lucadentella/PdL/OccupancyLNDecoder/v1/Eagle/LNOccupancy.brd

## EAGLE design OccupancyLNDecoder/v1/Eagle/LNOccupancy.brd (2016-12-05, an earlier design)

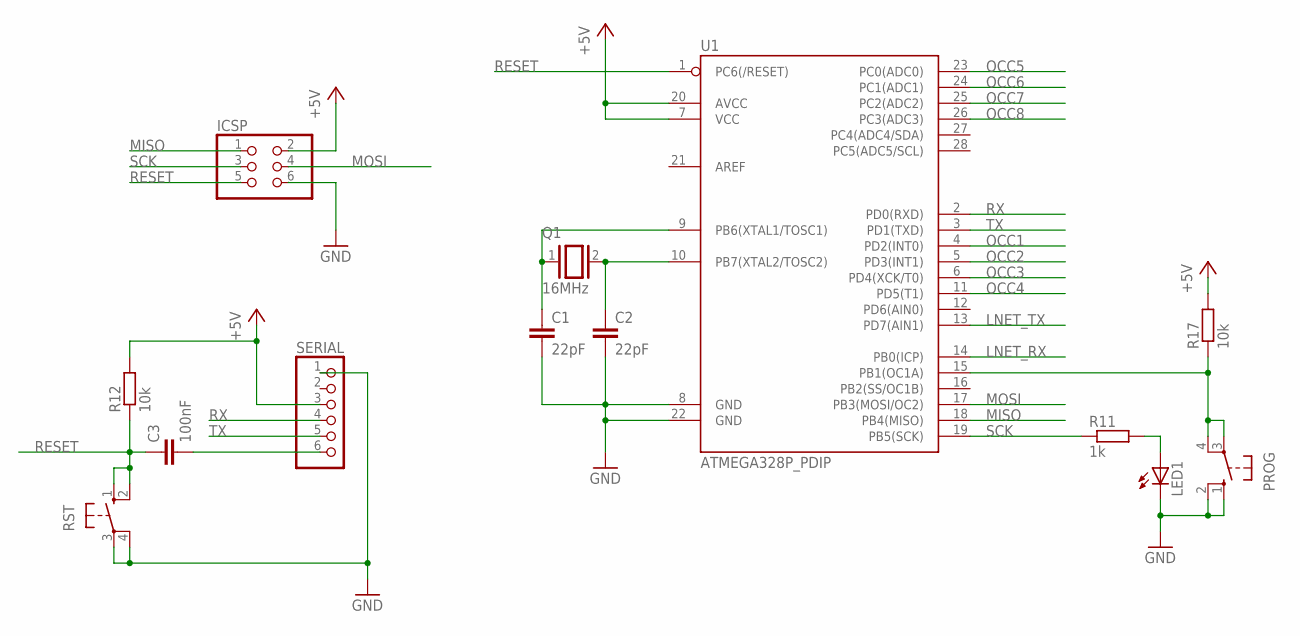
[picture p1: schematic LNOccupancy.sch, sheet 1]

Parts:
C1, C2: 22pF; C025-025X050
C3: 100nF; C050-025X075
ICSP: PINHD-2X3; 2X03
LED1: LED3MM
PROG: 10-XX; B3F-10XX
Q1: 16MHz; QS
R11: 1k; 0207/2V
R12, R17: 10k; 0207/2V
RST: 10-XX; B3F-10XX
SERIAL: PINHD-1X6; 1X06
U1: ATMEGA328P_PDIP; DIL28-3

Connections:
+5V: ICSP.2, R12.2, R17.2, SERIAL.3, U1.7 (VCC), U1.20 (AVCC); also elsewhere on the board
GND: C1.2, C2.2, ICSP.6, LED1.K (C), PROG.1 (S), PROG.2 (S1), RST.3, RST.4 (P1), SERIAL.1, U1.8 (GND), U1.22 (GND); also elsewhere on the board
LNET_RX: U1.14 (PB0(ICP)); also elsewhere on the board
LNET_TX: U1.13 (PD7(AIN1)); also elsewhere on the board
MISO: ICSP.1, U1.18 (PB4(MISO))
MOSI: ICSP.4, U1.17 (PB3(MOSI/OC2))
unnamed: C1.1, Q1.1, U1.9 (PB6(XTAL1/TOSC1))
unnamed: C2.1, Q1.2, U1.10 (PB7(XTAL2/TOSC2))
unnamed: LED1.A, R11.2
unnamed: C3.2, SERIAL.6
unnamed: PROG.3, PROG.4 (P1), R17.1, U1.15 (PB1(OC1A))
OCC1: U1.4 (PD2(INT0)); also elsewhere on the board
OCC2: U1.5 (PD3(INT1)); also elsewhere on the board
OCC3: U1.6 (PD4(XCK/T0)); also elsewhere on the board
OCC4: U1.11 (PD5(T1)); also elsewhere on the board
OCC5: U1.23 (PC0(ADC0)); also elsewhere on the board
OCC6: U1.24 (PC1(ADC1)); also elsewhere on the board
OCC7: U1.25 (PC2(ADC2)); also elsewhere on the board
OCC8: U1.26 (PC3(ADC3)); also elsewhere on the board
RESET: C3.1, ICSP.5, R12.1, RST.1 (S), RST.2 (S1), U1.1 (PC6(/RESET))
RX: SERIAL.4, U1.2 (PD0(RXD))
SCK: ICSP.3, R11.1, U1.19 (PB5(SCK))
TX: SERIAL.5, U1.3 (PD1(TXD))

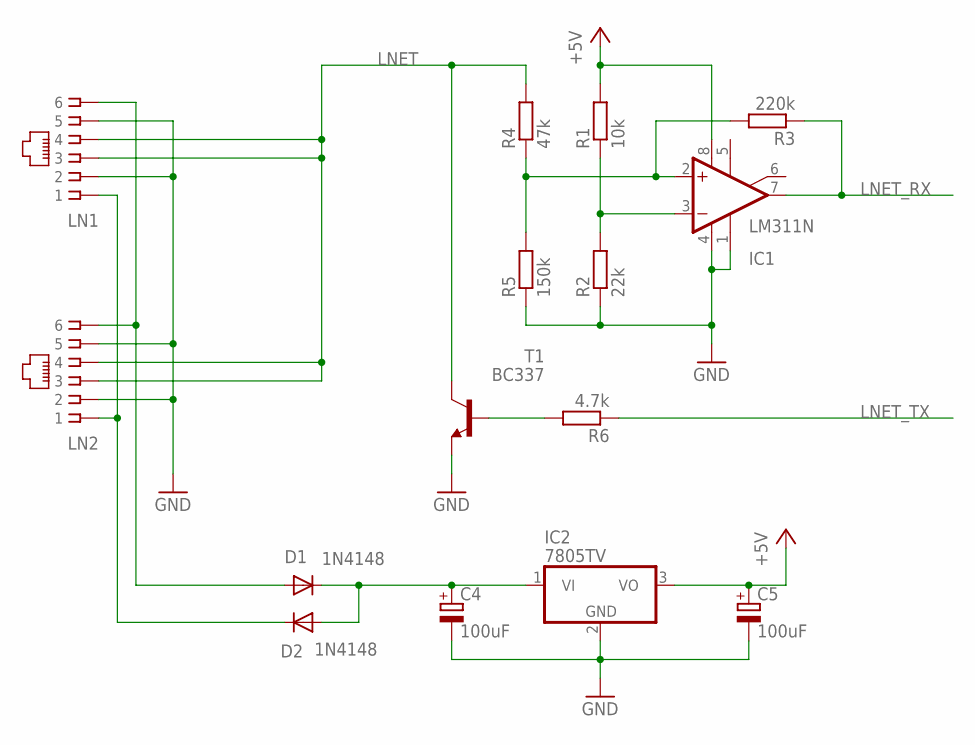
[picture p2: schematic LNOccupancy.sch, sheet 2]

Parts:
C4, C5: 100uF; E2,5-6
D1, D2: 1N4148; DO35-10
IC1: LM311N; DIL08
IC2: 7805TV; TO220V
LN1, LN2: RJ11-6X; RJ11-NO_SHIELD
R1: 10k; 0207/2V
R2: 22k; 0207/2V
R3: 220k; 0207/2V
R4: 47k; 0207/2V
R5: 150k; 0207/2V
R6: 4.7k; 0207/2V
T1: BC337; TO92

Connections:
+5V: C5.+, IC1.8 (V+), IC2.3 (VO), R1.2; also elsewhere on the board
GND: C4.-, C5.-, IC1.1 (GND), IC1.4 (V-), IC2.2 (GND), LN1.2, LN1.5, LN2.2, LN2.5, R2.1, R5.1, T1.1 (E); also elsewhere on the board
LNET: LN1.3, LN1.4, LN2.3, LN2.4, R4.2, T1.3 (C)
LNET_RX: IC1.7 (OUT), R3.1; also elsewhere on the board
LNET_TX: R6.1; also elsewhere on the board
unnamed: R6.2, T1.2 (B)
unnamed: IC1.3 (-IN), R1.1, R2.2
unnamed: IC1.2 (+IN), R3.2, R4.1, R5.2
unnamed: C4.+, D1.C, D2.A, IC2.1 (VI)
RAILSYNC_A: D1.A, LN1.6, LN2.6
RAILSYNC_B: D2.C, LN1.1, LN2.1

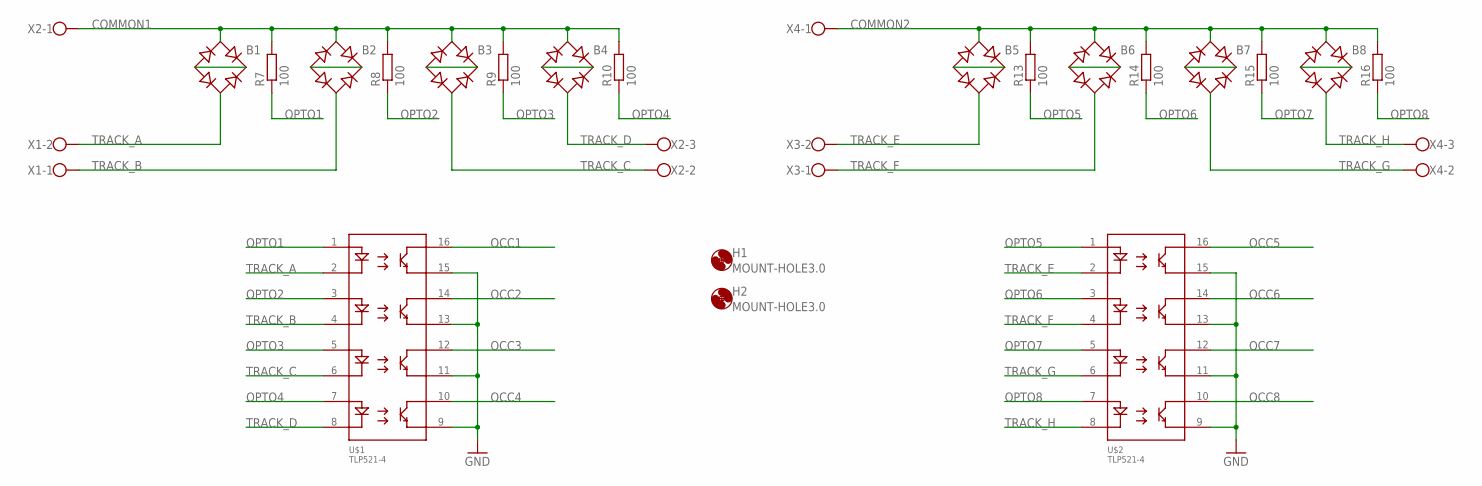
[picture p3: schematic LNOccupancy.sch, sheet 3]

Parts:
B1, B2, B3, B4, B5, B6, B7, B8: RB1A
H1, H2: MOUNT-HOLE3.0; 3,0
R7, R8, R9, R10, R13, R14, R15, R16: 100; 0207/2V
U$1, U$2: TLP521-4; DIL16
X1, X3: W237-102
X2, X4: W237-103

Connections:
COMMON1: B1.AC1, B2.AC1, B3.AC1, B4.AC1, R7.2, R8.2, R9.2, R10.2, X2.1
COMMON2: B5.AC1, B6.AC1, B7.AC1, B8.AC1, R13.2, R14.2, R15.2, R16.2, X4.1
GND: U$1.9, U$1.11, U$1.13, U$1.15, U$2.9, U$2.11, U$2.13, U$2.15; also elsewhere on the board
unnamed: B1.+, B1.-
unnamed: B3.+, B3.-
unnamed: B4.+, B4.-
unnamed: B2.+, B2.-
unnamed: B5.+, B5.-
unnamed: B6.+, B6.-
unnamed: B7.+, B7.-
unnamed: B8.+, B8.-
OCC1: U$1.16; also elsewhere on the board
OCC2: U$1.14; also elsewhere on the board
OCC3: U$1.12; also elsewhere on the board
OCC4: U$1.10; also elsewhere on the board
OCC5: U$2.16; also elsewhere on the board
OCC6: U$2.14; also elsewhere on the board
OCC7: U$2.12; also elsewhere on the board
OCC8: U$2.10; also elsewhere on the board
OPTO1: R7.1, U$1.1
OPTO2: R8.1, U$1.3
OPTO3: R9.1, U$1.5
OPTO4: R10.1, U$1.7
OPTO5: R13.1, U$2.1
OPTO6: R14.1, U$2.3
OPTO7: R15.1, U$2.5
OPTO8: R16.1, U$2.7
TRACK_A: B1.AC2, U$1.2, X1.2
TRACK_B: B2.AC2, U$1.4, X1.1
TRACK_C: B3.AC2, U$1.6, X2.2
TRACK_D: B4.AC2, U$1.8, X2.3
TRACK_E: B5.AC2, U$2.2, X3.2
TRACK_F: B6.AC2, U$2.4, X3.1
TRACK_G: B7.AC2, U$2.6, X4.2
TRACK_H: B8.AC2, U$2.8, X4.3

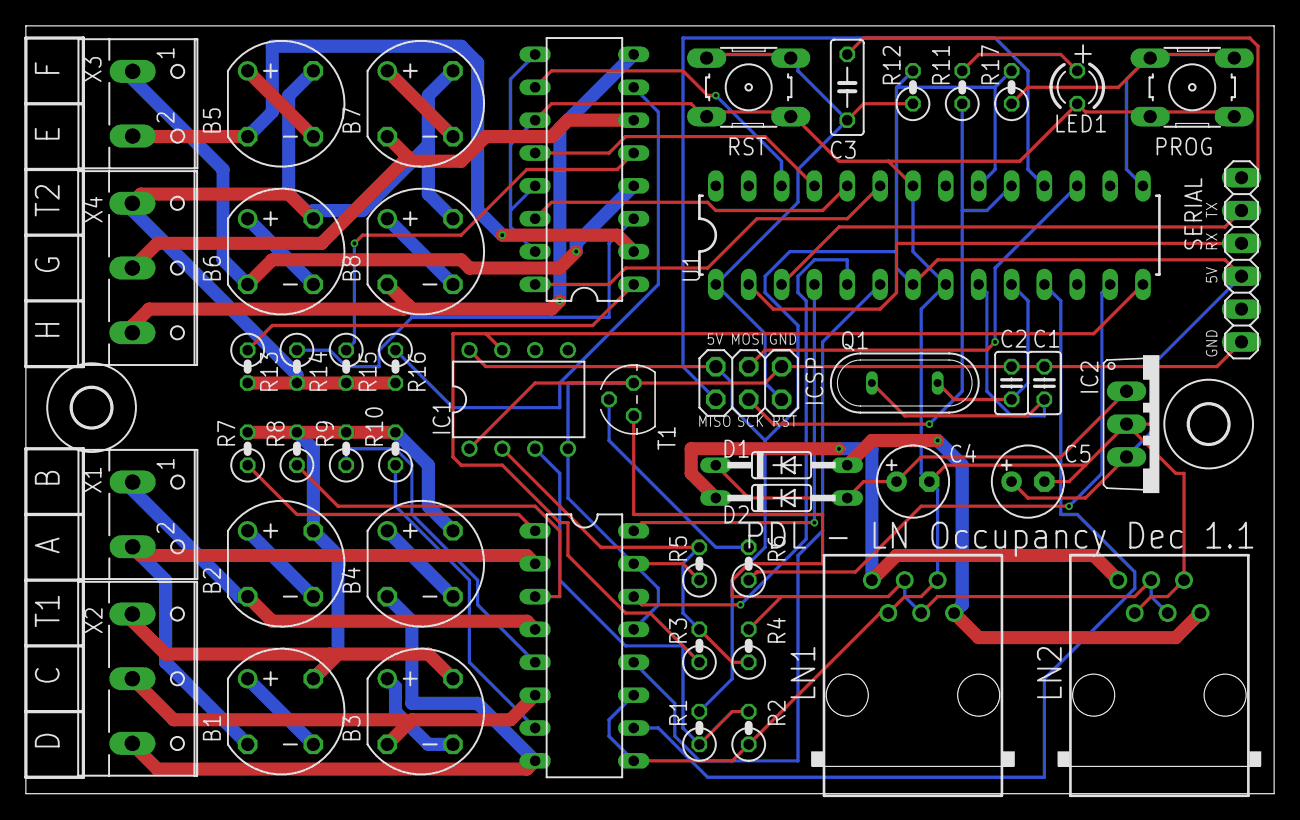
[picture p4: board LNOccupancy.brd from above]

Board: 2 copper layers, 96.5 x 59.3 mm, 52 parts (0 on the bottom side), 56 nets.
